Pingouin-Centrale-Bot/2026-PCB-Module-4-layers/CFR_module_v2.step

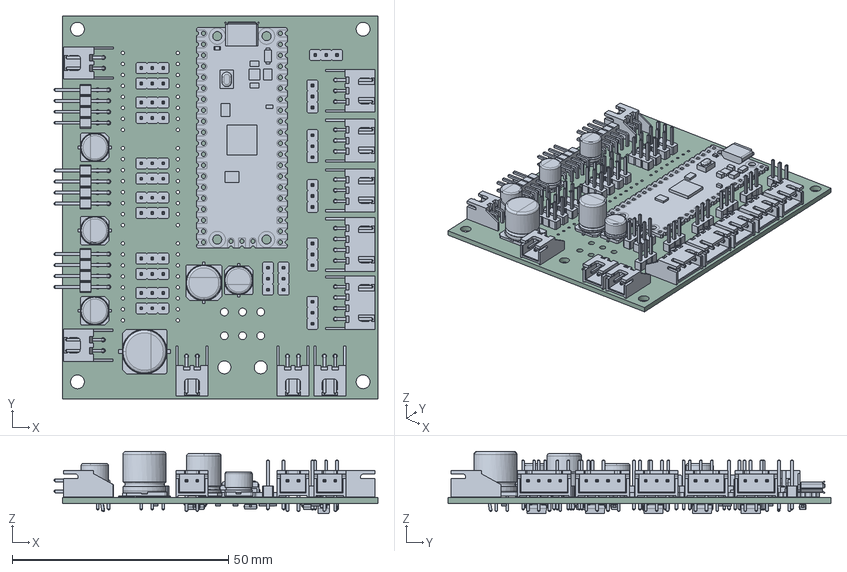
[picture p1: CAD file, 2026-04-03]
CFR_module_v2.step
74.8 x 88.5 x 14.3 mm
PinHeader_1x03_P2.54mm_Vertical x 20
PinHeader_2x04_P2.54mm_Horizontal x 3
JST_XH_S3B-XH-A_1x03_P2.50mm_Horizontal x 3
CP_Elec_10x10.5
JST_XH_S4B-XH-A_1x04_P2.50mm_Horizontal x 2
CP_Elec_6.3x7.7 x 3
RaspberryPi_Pico_Module_KiCad
JST_XH_S2B-XH-A_1x02_P2.50mm_Horizontal x 5
CP_Elec_6.3x5.8
CP_Elec_8x10
D_SOD-123 x 4
D_SMA x 5
R_0805_2012Metric x 7
SOT-23
CFR_module_v2_PCB
