Pingouin-Centrale-Bot/2026-PCB-Module-4-layers/CFR_module_v2.kicad_pcb

## KiCad design CFR_module_v2.kicad_pcb (2026-04-03)

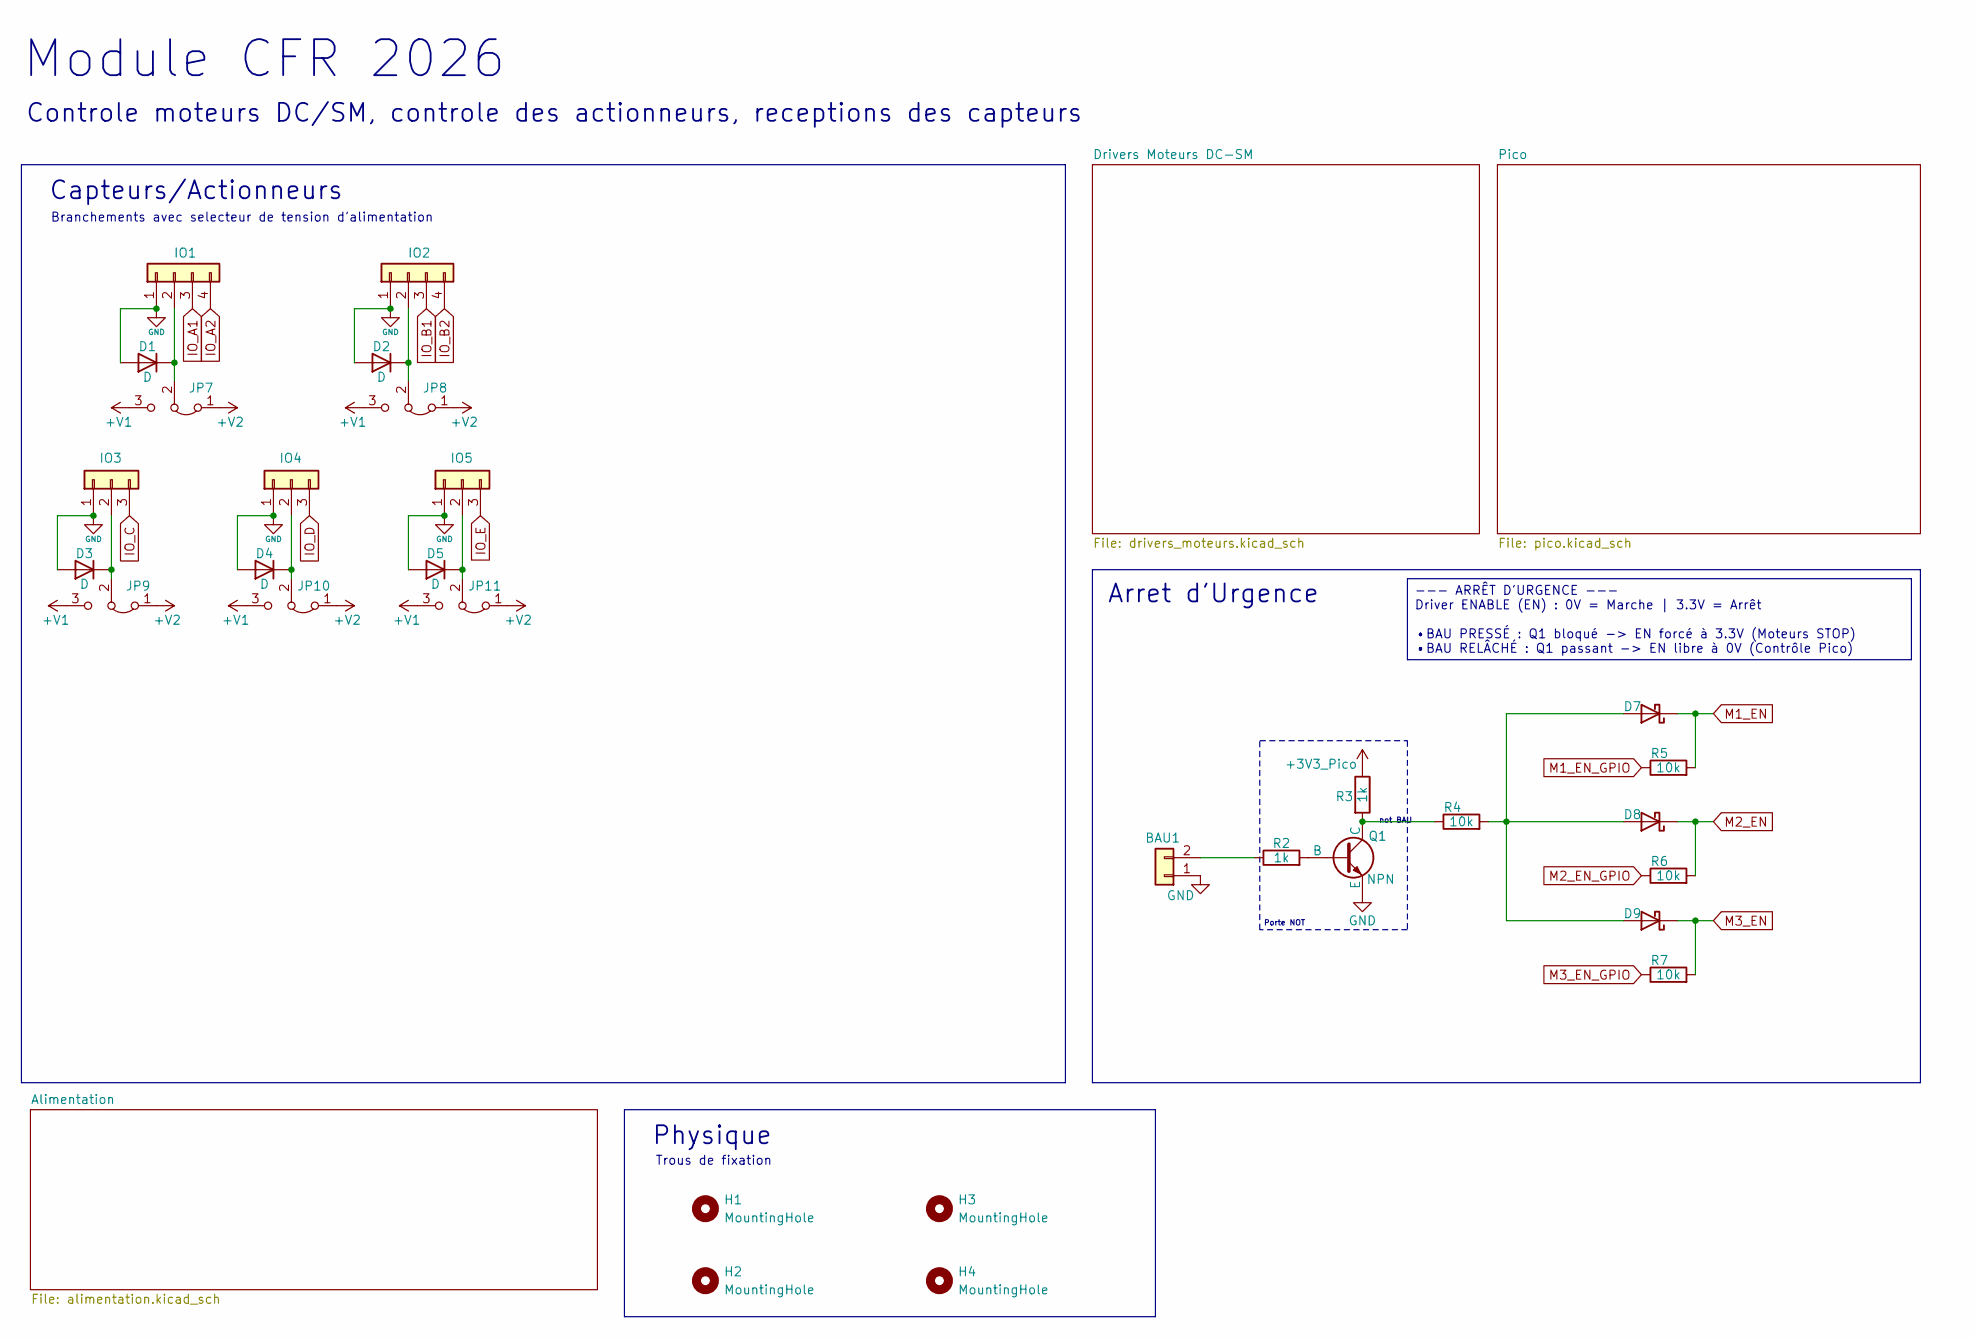
[picture p2: schematic CFR_module_v2.kicad_sch, Module Principal CFR 2026]

Parts:
BAU1: Conn_01x02; JST_XH_S2B-XH-A_1x02_P2.50mm_Horizontal
D1, D2, D3, D4, D5: D; D_SMA_Handsoldering
D7, D8, D9: D_Schottky; D_SOD-123
H1, H2, H3, H4: MountingHole; MountingHole_3.2mm_M3
IO1, IO2: Conn_01x04; JST_XH_S4B-XH-A_1x04_P2.50mm_Horizontal
IO3, IO4, IO5: Conn_01x03; JST_XH_S3B-XH-A_1x03_P2.50mm_Horizontal
JP7, JP8, JP9, JP10, JP11: Jumper_3_Bridged12; PinHeader_1x03_P2.54mm_Vertical
Q1: NPN; SOT-23
R2, R3: 1k; R_0805_2012Metric_Pad1.20x1.40mm_HandSolder
R4, R5, R6, R7: 10k; R_0805_2012Metric_Pad1.20x1.40mm_HandSolder

Connections:
+3V3_Pico: R3.1; also elsewhere on the board
+V1: JP7.3 (B), JP8.3 (B), JP9.3 (B), JP10.3 (B), JP11.3 (B); also elsewhere on the board
+V2: JP7.1 (A), JP8.1 (A), JP9.1 (A), JP10.1 (A), JP11.1 (A); also elsewhere on the board
GND: BAU1.1, D1.2 (A), D2.2 (A), D3.2 (A), D4.2 (A), D5.2 (A), IO1.1, IO2.1, IO3.1, IO4.1, IO5.1, Q1.3 (E); also elsewhere on the board
IO_A1: IO1.3; also elsewhere on the board
IO_A2: IO1.4; also elsewhere on the board
IO_B1: IO2.3; also elsewhere on the board
IO_B2: IO2.4; also elsewhere on the board
IO_C: IO3.3; also elsewhere on the board
IO_D: IO4.3; also elsewhere on the board
IO_E: IO5.3; also elsewhere on the board
M1_EN: D7.1 (K), R5.2; also elsewhere on the board
M1_EN_GPIO: R5.1; also elsewhere on the board
M2_EN: D8.1 (K), R6.2; also elsewhere on the board
M2_EN_GPIO: R6.1; also elsewhere on the board
M3_EN: D9.1 (K), R7.2; also elsewhere on the board
M3_EN_GPIO: R7.1; also elsewhere on the board
unnamed: BAU1.2, R2.1
unnamed: D1.1 (K), IO1.2, JP7.2 (C)
unnamed: D2.1 (K), IO2.2, JP8.2 (C)
unnamed: D3.1 (K), IO3.2, JP9.2 (C)
unnamed: D4.1 (K), IO4.2, JP10.2 (C)
unnamed: D5.1 (K), IO5.2, JP11.2 (C)
unnamed: D7.2 (A), D8.2 (A), D9.2 (A), R4.2
unnamed: Q1.2 (B), R2.2
unnamed: Q1.1 (C), R3.2, R4.1

Notes on the sheet:
Physique
Controle moteurs DC/SM, controle des actionneurs, receptions des capteurs
Trous de fixation
Module CFR 2026
Porte NOT
Capteurs/Actionneurs
not BAU
Branchements avec selecteur de tension d'alimentation
Arret d'Urgence
--- ARRÊT D'URGENCE --- Driver ENABLE (EN) : 0V = Marche | 3.3V = Arrêt •BAU PRESSÉ : Q1 bloqué -> EN forcé à 3.3V (Moteurs STOP) •BAU RELÂCHÉ : Q1 passant -> EN libre à 0V (Contrôle Pico)

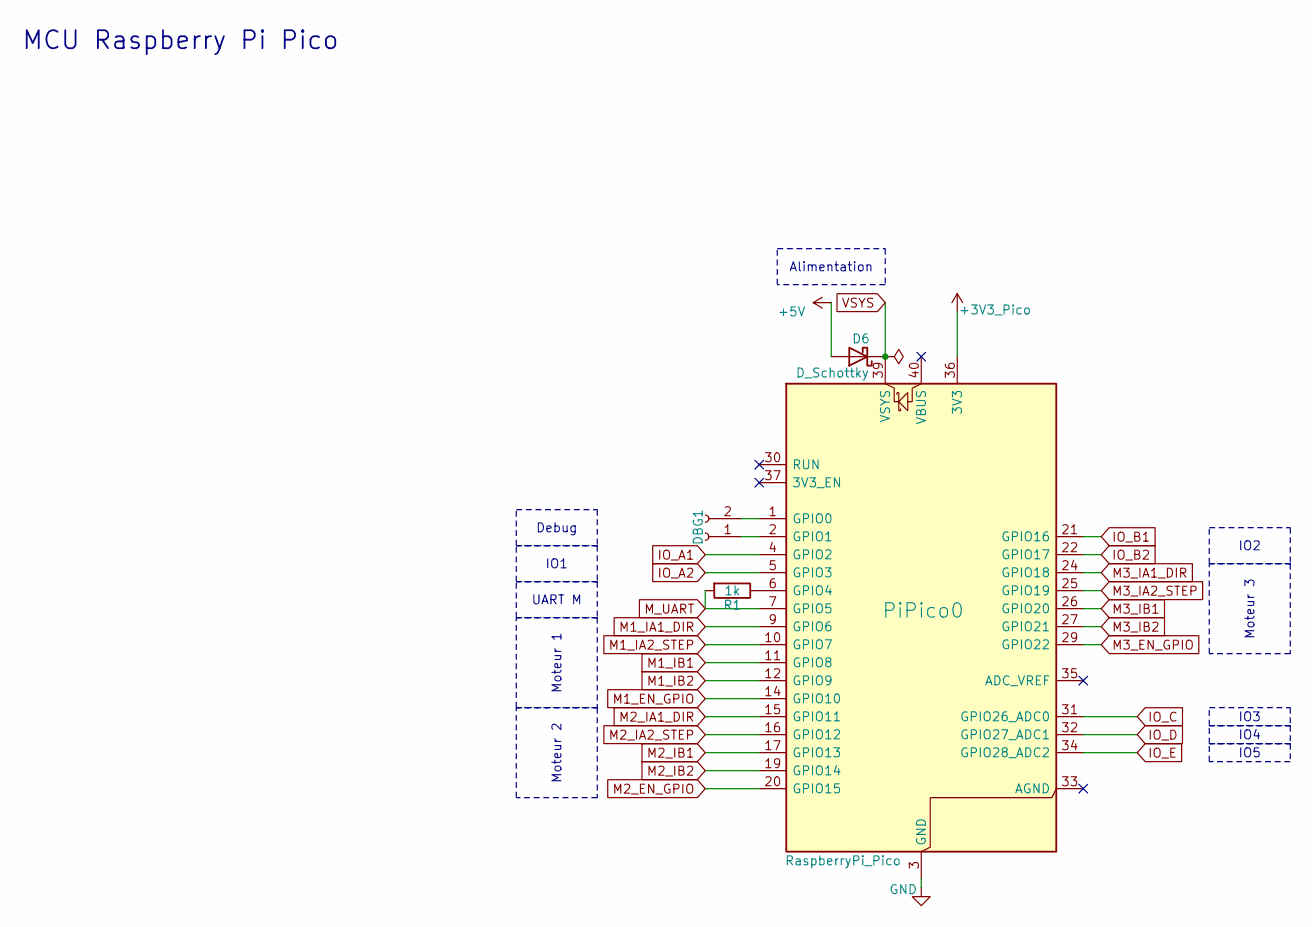
[picture p3: schematic pico.kicad_sch]

Parts:
D6: D_Schottky; D_SOD-123
DBG1: Conn_01x02_Socket; JST_XH_S2B-XH-A_1x02_P2.50mm_Horizontal
PiPico0: RaspberryPi_Pico; RaspberryPi_Pico_Common_SMD
R1: 1k; R_0805_2012Metric_Pad1.20x1.40mm_HandSolder

Connections:
+3V3_Pico: PiPico0.36 (3V3); also elsewhere on the board
+5V: D6.2 (A); also elsewhere on the board
GND: PiPico0.3 (GND), PiPico0.8 (GND), PiPico0.13 (GND), PiPico0.18 (GND), PiPico0.23 (GND), PiPico0.28 (GND), PiPico0.38 (GND); also elsewhere on the board
IO_A1: PiPico0.4 (GPIO2); also elsewhere on the board
IO_A2: PiPico0.5 (GPIO3); also elsewhere on the board
IO_B1: PiPico0.21 (GPIO16); also elsewhere on the board
IO_B2: PiPico0.22 (GPIO17); also elsewhere on the board
IO_C: PiPico0.31 (GPIO26_ADC0); also elsewhere on the board
IO_D: PiPico0.32 (GPIO27_ADC1); also elsewhere on the board
IO_E: PiPico0.34 (GPIO28_ADC2); also elsewhere on the board
M1_EN_GPIO: PiPico0.14 (GPIO10); also elsewhere on the board
M1_IA1_DIR: PiPico0.9 (GPIO6); also elsewhere on the board
M1_IA2_STEP: PiPico0.10 (GPIO7); also elsewhere on the board
M1_IB1: PiPico0.11 (GPIO8); also elsewhere on the board
M1_IB2: PiPico0.12 (GPIO9); also elsewhere on the board
M2_EN_GPIO: PiPico0.20 (GPIO15); also elsewhere on the board
M2_IA1_DIR: PiPico0.15 (GPIO11); also elsewhere on the board
M2_IA2_STEP: PiPico0.16 (GPIO12); also elsewhere on the board
M2_IB1: PiPico0.17 (GPIO13); also elsewhere on the board
M2_IB2: PiPico0.19 (GPIO14); also elsewhere on the board
M3_EN_GPIO: PiPico0.29 (GPIO22); also elsewhere on the board
M3_IA1_DIR: PiPico0.24 (GPIO18); also elsewhere on the board
M3_IA2_STEP: PiPico0.25 (GPIO19); also elsewhere on the board
M3_IB1: PiPico0.26 (GPIO20); also elsewhere on the board
M3_IB2: PiPico0.27 (GPIO21); also elsewhere on the board
M_UART: PiPico0.7 (GPIO5), R1.2; also elsewhere on the board
unnamed: DBG1.1, PiPico0.2 (GPIO1)
unnamed: DBG1.2, PiPico0.1 (GPIO0)
unnamed: PiPico0.6 (GPIO4), R1.1
VSYS: D6.1 (K), PiPico0.39 (VSYS)

Notes on the sheet:
MCU Raspberry Pi Pico
IO5
IO4
IO3
Alimentation
Moteur 1
Moteur 2
UART M
IO1
Moteur 3
Debug
IO2

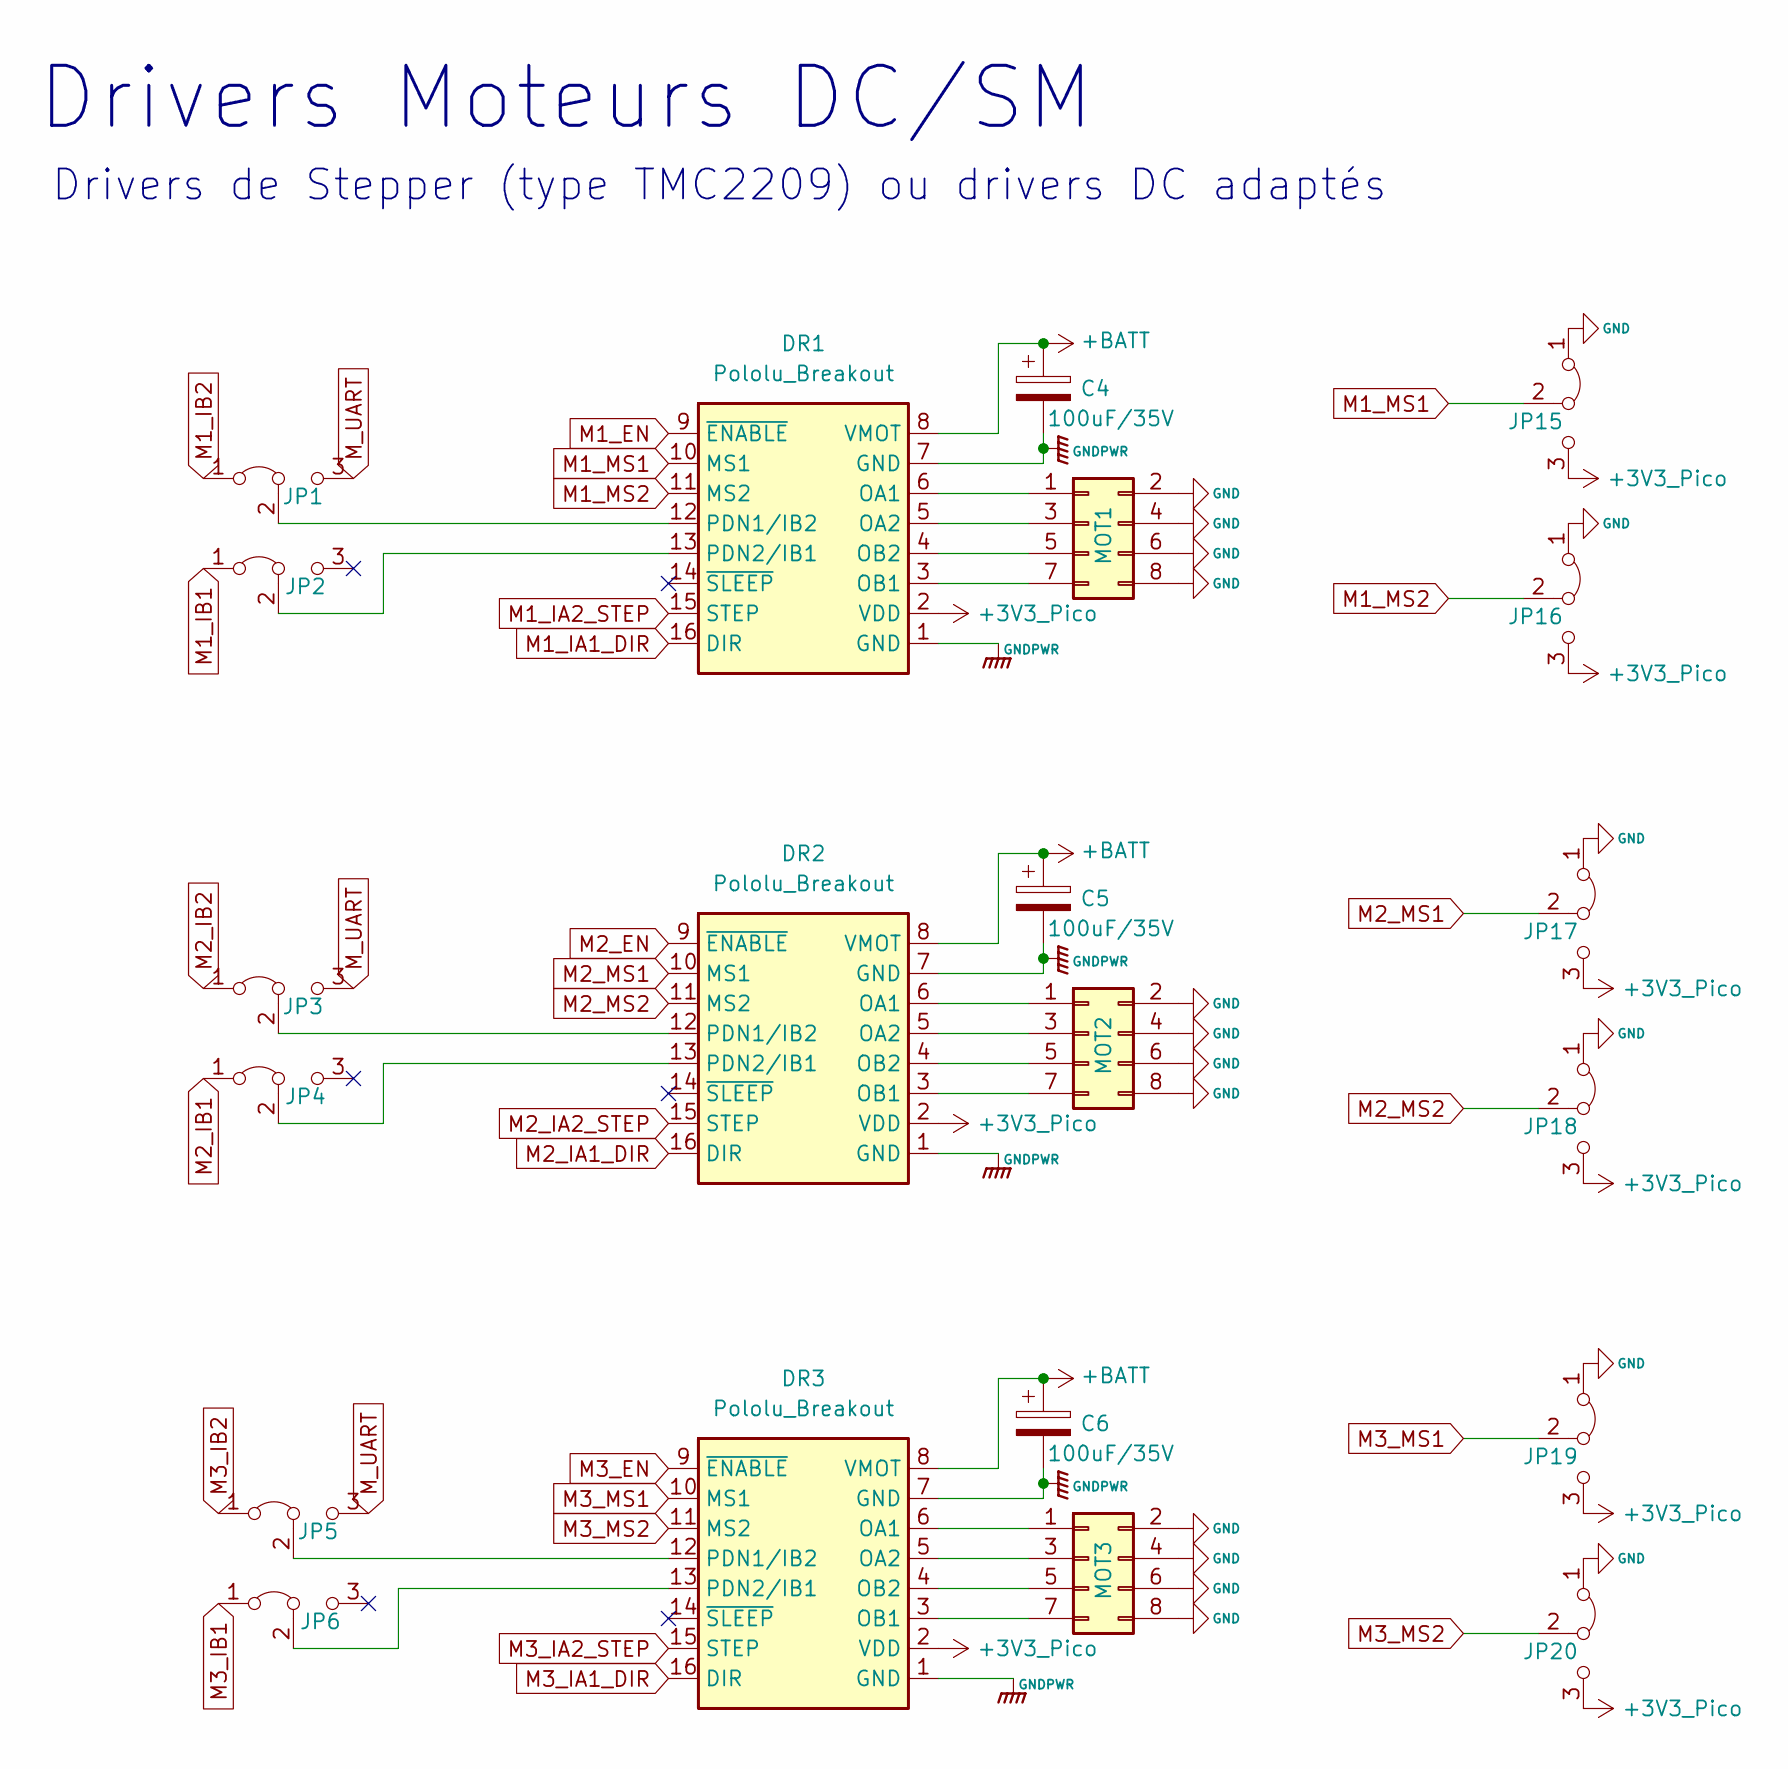
[picture p4: schematic drivers_moteurs.kicad_sch]

Parts:
C4, C5, C6: 100uF/35V; CP_Elec_6.3x7.7
DR1, DR2, DR3: Pololu_Breakout; Pololu_Breakout-16_15.2x20.3mm_Better_Silkscreen
JP1, JP2, JP3, JP4, JP5, JP6, JP15, JP16, JP17, JP18, JP19, JP20: Jumper_3_Bridged12; PinHeader_1x03_P2.54mm_Vertical
MOT1, MOT2, MOT3: Conn_02x04_Odd_Even; PinHeader_2x04_P2.54mm_Horizontal

Connections:
+3V3_Pico: DR1.2 (VDD), DR2.2 (VDD), DR3.2 (VDD), JP15.3 (B), JP16.3 (B), JP17.3 (B), JP18.3 (B), JP19.3 (B), JP20.3 (B); also elsewhere on the board
+BATT: C4.1, C5.1, C6.1, DR1.8 (VMOT), DR2.8 (VMOT), DR3.8 (VMOT); also elsewhere on the board
GND: C4.2, C5.2, C6.2, DR1.1 (GND), DR1.7 (GND), DR2.1 (GND), DR2.7 (GND), DR3.1 (GND), DR3.7 (GND), JP15.1 (A), JP16.1 (A), JP17.1 (A), JP18.1 (A), JP19.1 (A), JP20.1 (A), MOT1.2, MOT1.4, MOT1.6, MOT1.8, MOT2.2, MOT2.4, MOT2.6, MOT2.8, MOT3.2, MOT3.4, MOT3.6, MOT3.8; also elsewhere on the board
M1_EN: DR1.9 (~ENABLE); also elsewhere on the board
M1_IA1_DIR: DR1.16 (DIR); also elsewhere on the board
M1_IA2_STEP: DR1.15 (STEP); also elsewhere on the board
M1_IB1: JP2.1 (A); also elsewhere on the board
M1_IB2: JP1.1 (A); also elsewhere on the board
M1_MS1: DR1.10 (MS1), JP15.2 (C)
M1_MS2: DR1.11 (MS2), JP16.2 (C)
M2_EN: DR2.9 (~ENABLE); also elsewhere on the board
M2_IA1_DIR: DR2.16 (DIR); also elsewhere on the board
M2_IA2_STEP: DR2.15 (STEP); also elsewhere on the board
M2_IB1: JP4.1 (A); also elsewhere on the board
M2_IB2: JP3.1 (A); also elsewhere on the board
M2_MS1: DR2.10 (MS1), JP17.2 (C)
M2_MS2: DR2.11 (MS2), JP18.2 (C)
M3_EN: DR3.9 (~ENABLE); also elsewhere on the board
M3_IA1_DIR: DR3.16 (DIR); also elsewhere on the board
M3_IA2_STEP: DR3.15 (STEP); also elsewhere on the board
M3_IB1: JP6.1 (A); also elsewhere on the board
M3_IB2: JP5.1 (A); also elsewhere on the board
M3_MS1: DR3.10 (MS1), JP19.2 (C)
M3_MS2: DR3.11 (MS2), JP20.2 (C)
M_UART: JP1.3 (B), JP3.3 (B), JP5.3 (B); also elsewhere on the board
unnamed: DR1.6 (OA1), MOT1.1
unnamed: DR1.5 (OA2), MOT1.3
unnamed: DR1.3 (OB1), MOT1.7
unnamed: DR1.4 (OB2), MOT1.5
unnamed: DR1.12 (PDN1/IB2), JP1.2 (C)
unnamed: DR1.13 (PDN2/IB1), JP2.2 (C)
unnamed: DR2.6 (OA1), MOT2.1
unnamed: DR2.5 (OA2), MOT2.3
unnamed: DR2.3 (OB1), MOT2.7
unnamed: DR2.4 (OB2), MOT2.5
unnamed: DR2.12 (PDN1/IB2), JP3.2 (C)
unnamed: DR2.13 (PDN2/IB1), JP4.2 (C)
unnamed: DR3.6 (OA1), MOT3.1
unnamed: DR3.5 (OA2), MOT3.3
unnamed: DR3.3 (OB1), MOT3.7
unnamed: DR3.4 (OB2), MOT3.5
unnamed: DR3.12 (PDN1/IB2), JP5.2 (C)
unnamed: DR3.13 (PDN2/IB1), JP6.2 (C)

Notes on the sheet:
Drivers de Stepper (type TMC2209) ou drivers DC adaptés
Drivers Moteurs DC/SM

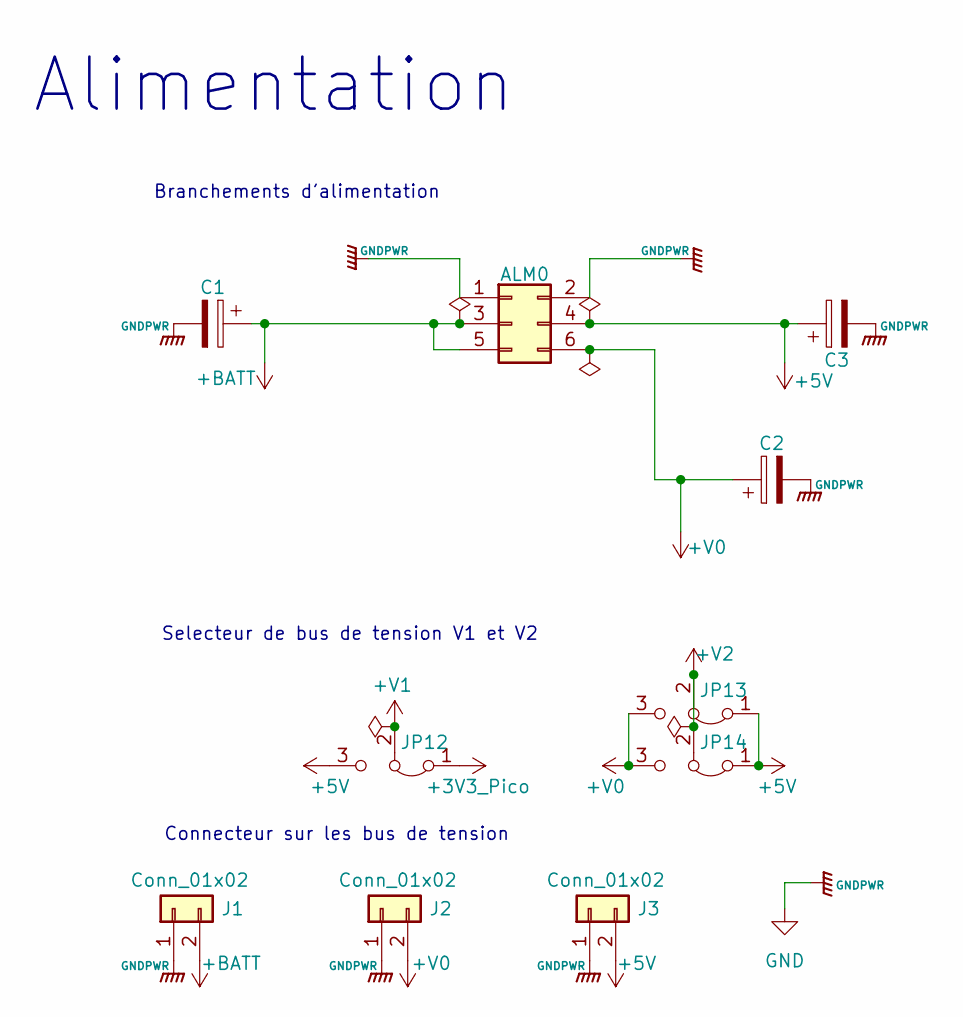
[picture p5: schematic alimentation.kicad_sch]

Parts:
ALM0: Conn_02x03_Odd_Even; Molex_Mini-Fit_Jr_5569-06A2_2x03_P4.20mm_Horizontal
C1: C_Polarized; CP_Elec_10x10.5
C2: C_Polarized; CP_Elec_8x10
C3: C_Polarized; CP_Elec_6.3x7.7
J1, J2, J3: Conn_01x02; JST_XH_S2B-XH-A_1x02_P2.50mm_Horizontal
JP12, JP13, JP14: Jumper_3_Bridged12; PinHeader_1x03_P2.54mm_Vertical

Connections:
+3V3_Pico: JP12.1 (A); also elsewhere on the board
+5V: ALM0.4, C3.1, J3.2, JP12.3 (B), JP13.1 (A), JP14.1 (A); also elsewhere on the board
+BATT: ALM0.3, ALM0.5, C1.1, J1.2; also elsewhere on the board
+V0: ALM0.6, C2.1, J2.2, JP13.3 (B), JP14.3 (B)
+V1: JP12.2 (C); also elsewhere on the board
+V2: JP13.2 (C), JP14.2 (C); also elsewhere on the board
GND: ALM0.1, ALM0.2, C1.2, C2.2, C3.2, J1.1, J2.1, J3.1; also elsewhere on the board

Notes on the sheet:
Selecteur de bus de tension V1 et V2
Alimentation
Branchements d'alimentation
Connecteur sur les bus de tension

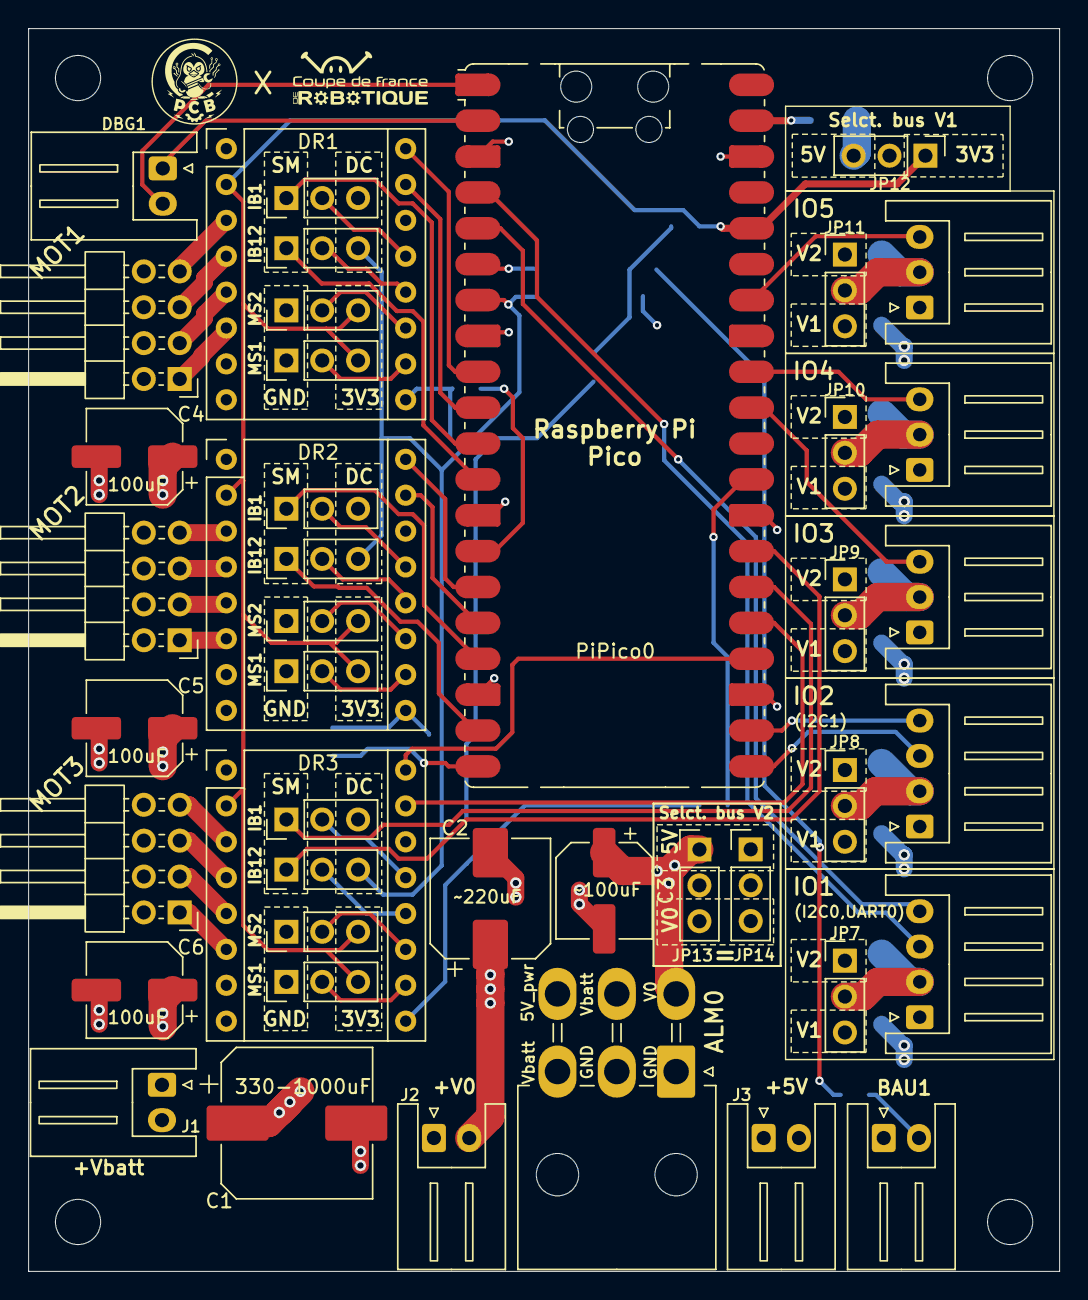
[picture p6: board CFR_module_v2.kicad_pcb from above]

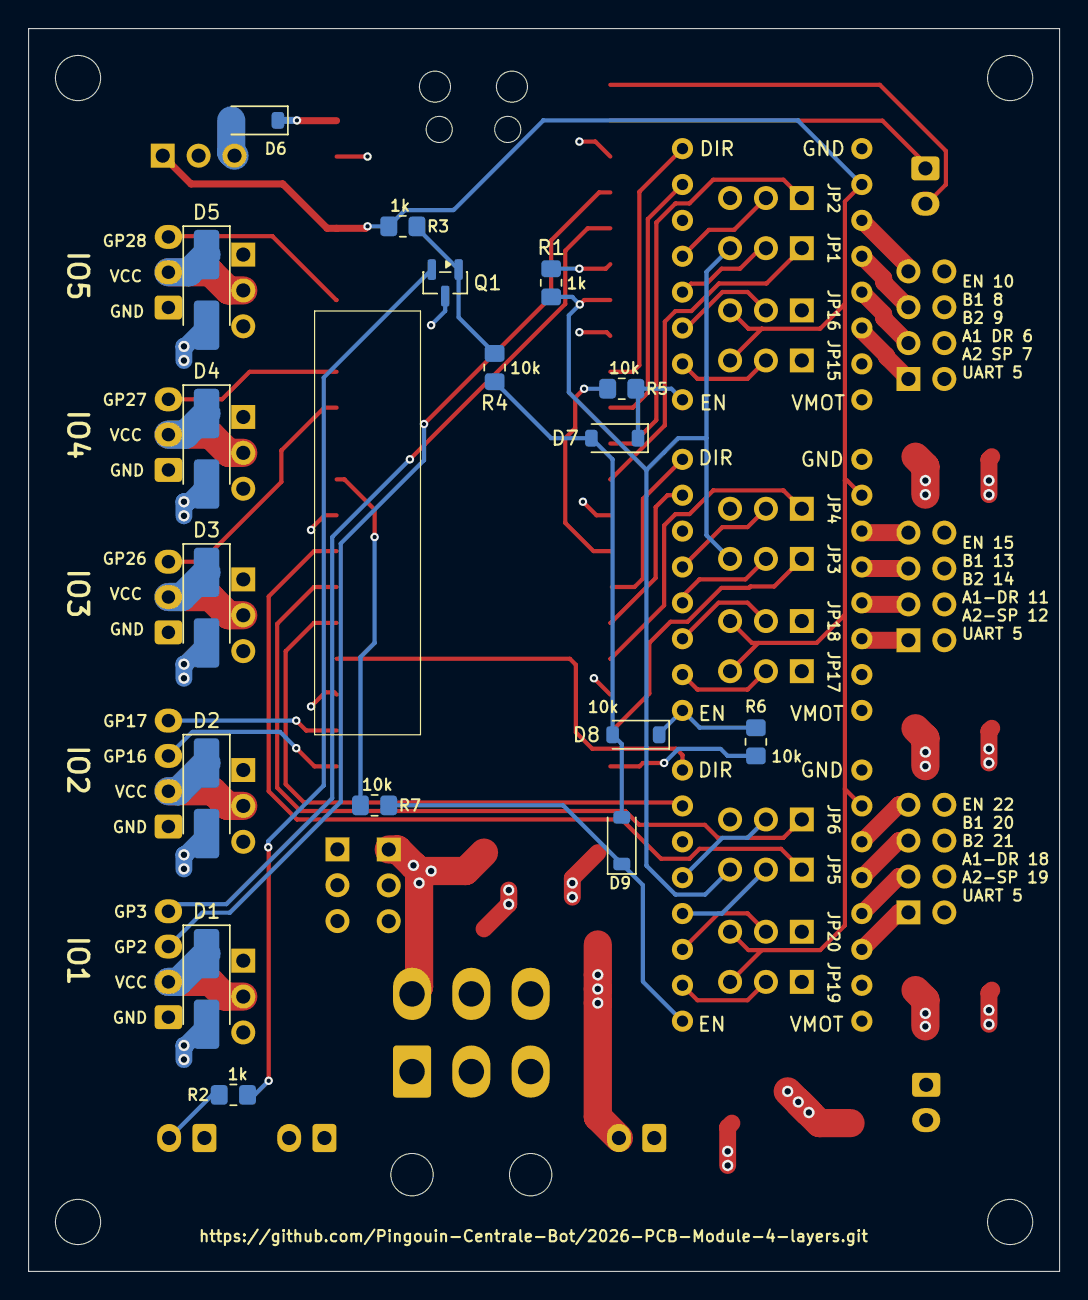
[picture p7: board CFR_module_v2.kicad_pcb from below]

Board: 4 copper layers, 73.0 x 88.0 mm, 65 parts (17 on the bottom side), 70 nets.
