Pingouin-Centrale-Bot/2026-PCB-Module-4-layers/(commit log)

2026-03-25 placement des empreintes début
    [CFR_module_v2.kicad_pcb, alimentation.kicad_sch, drivers_moteurs.kicad_sch]
2026-03-29 tout connecté
    [CFR_module_v2.kicad_pcb, alimentation.kicad_sch, drivers_moteurs.kicad_sch]
2026-03-29 v2 finalisé
    [CFR_module_v2.kicad_pcb, alimentation.kicad_sch]
2026-04-03 correction erreurs DRC
    [CFR_module_v2.kicad_pcb]
